Le-Brown/gulugulu/README.md

# gulugulu
Gulugulu drink-maker made by Xu Le and Zhou Mingyuan, which is The special prize work of The 26th Hardware Design Competition at Tsinghua University.

**Finished product schematic:**

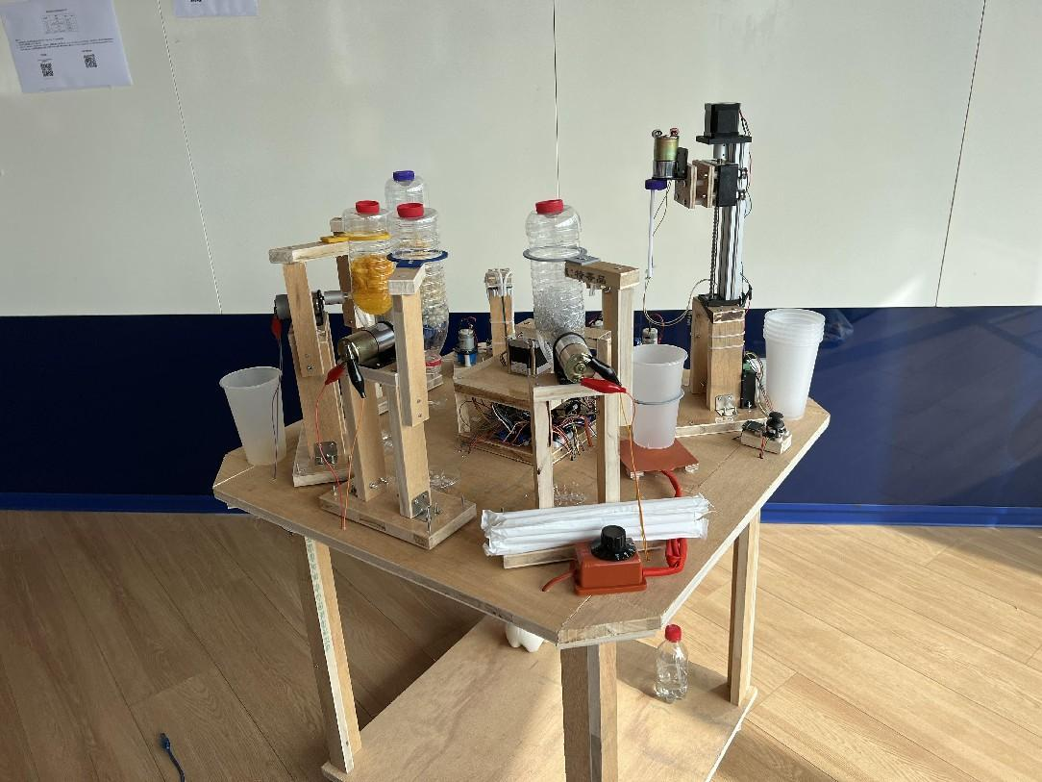
[picture p1: img/成品.png]
成品


Please refer to the project report for project details.
