Le-Brown/gulugulu/Code/README.md

gulugulu-drink-maker文件夹下为下载至饮料机主控单片机Arduino Mega 2560的源代码文件。用于控制饮料机获取订单信息，依照订单信息制作饮品。

wifi_module文件夹下为下载至WifI模块ESP8266的源代码文件。用于搭建网页服务器，与用户交互，获取点单数据，发送至饮料机主控芯片。

Web code文件夹存放了当时设计在线点单网页时的源码，具体使用在了wifi_module.ino文件中。本身并不作为工程的直接源码。
