Le-Brown/gulugulu/3D_print/STL/1.7mm_part2.stl

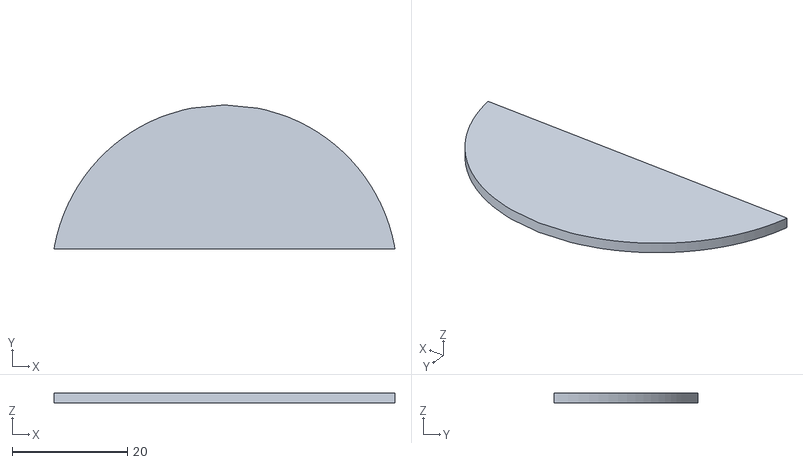
[picture p9: CAD file, 2024-03-18]
3D_print/STL/1.7mm_part2.stl
59.1 x 25.0 x 1.70
