Le-Brown/gulugulu/3D_print/STL/叶片part1.stl

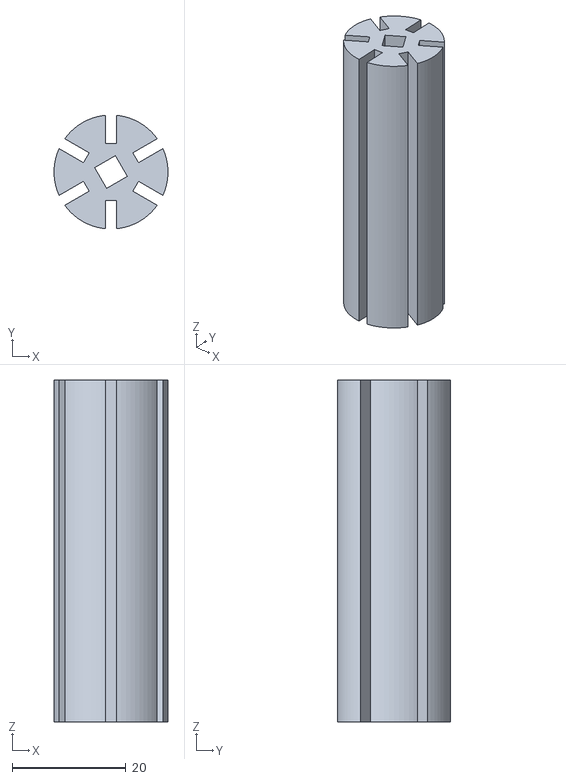
[picture p10: CAD file, 2024-03-18]
3D_print/STL/叶片part1.stl
20.0 x 19.9 x 60.0
