Le-Brown/gulugulu/3D_print/STL/Holder_ver2.stl

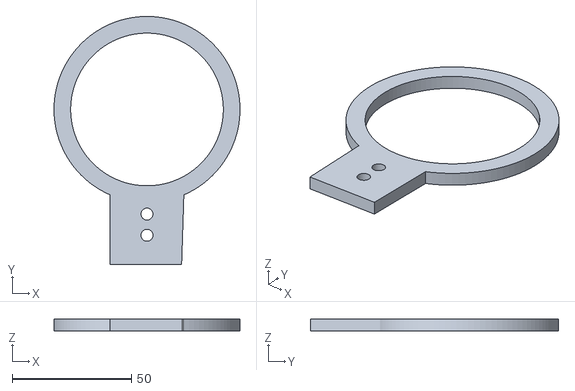
[picture p11: CAD file, 2024-03-18]
3D_print/STL/Holder_ver2.stl
78.0 x 104.0 x 5.00
