Le-Brown/gulugulu/3D_print/STL/arm_holder.stl

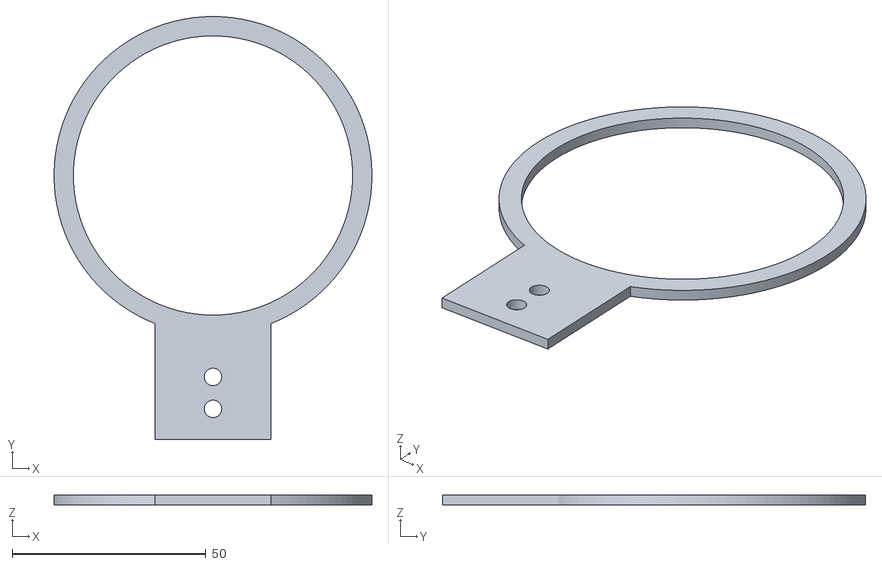
[picture p12: CAD file, 2024-03-18]
3D_print/STL/arm_holder.stl
82.0 x 109.1 x 2.50
