Le-Brown/gulugulu/3D_print/STL/0.9mmpart2stl.stl

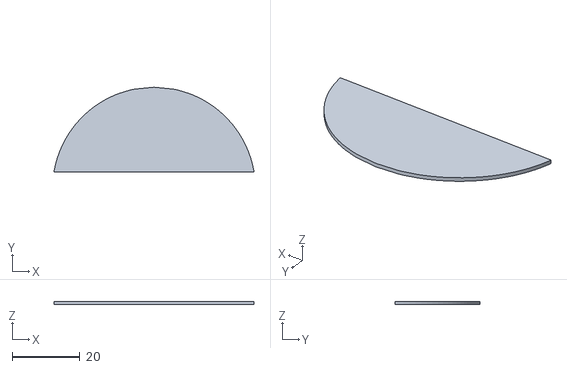
[picture p13: CAD file, 2024-03-18]
3D_print/STL/0.9mmpart2stl.stl
59.1 x 25.0 x 0.9
