Le-Brown/gulugulu/3D_print/STL/3.5mm.stl

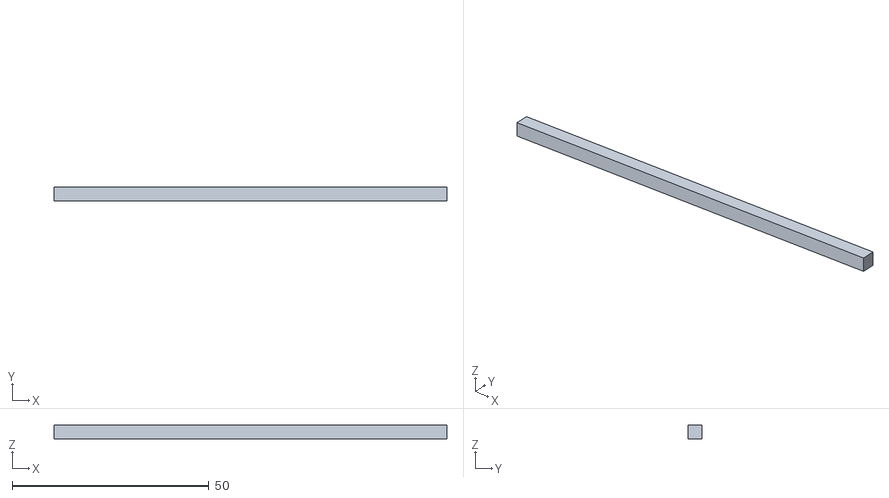
[picture p14: CAD file, 2024-03-18]
3D_print/STL/3.5mm.stl
100.0 x 3.50 x 3.50
