Le-Brown/gulugulu/3D_print/STL/part1.stl

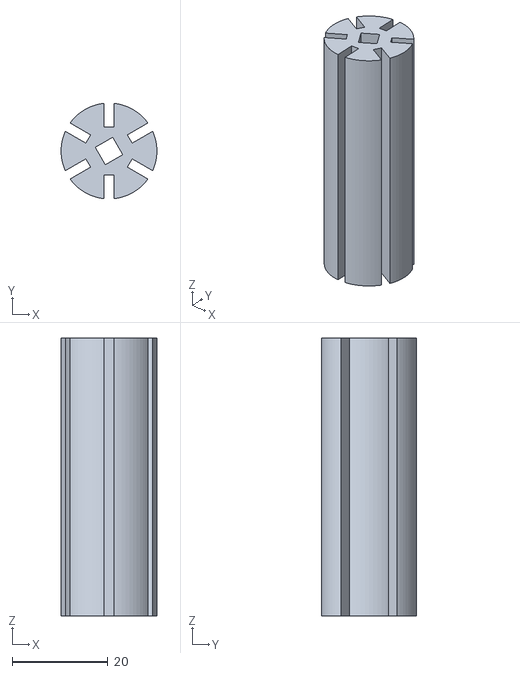
[picture p15: CAD file, 2024-03-18]
3D_print/STL/part1.stl
20.0 x 19.9 x 58.0
