Le-Brown/gulugulu/3D_print/STL/叶片part2.stl

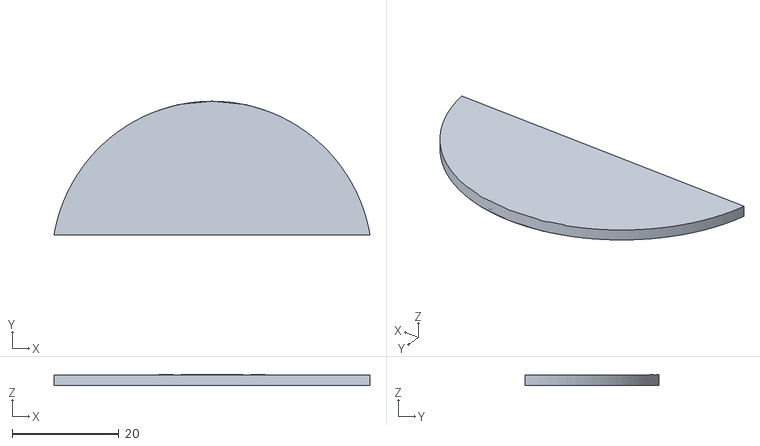
[picture p16: CAD file, 2024-03-18]
3D_print/STL/叶片part2.stl
59.1 x 25.0 x 2.00
