Le-Brown/gulugulu/3D_print/STL/holder2.5mm.stl

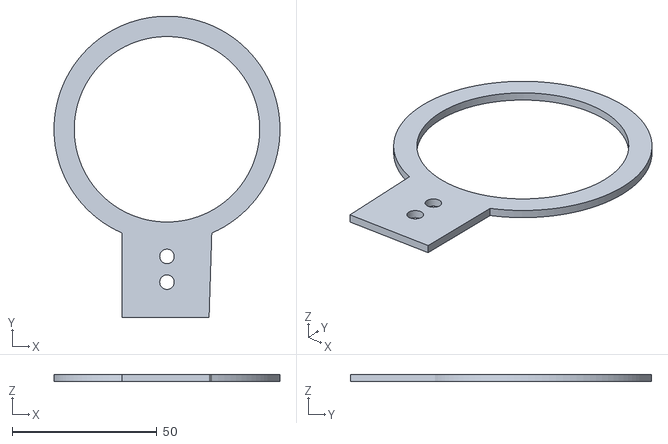
[picture p17: CAD file, 2024-03-18]
3D_print/STL/holder2.5mm.stl
78.0 x 104.0 x 2.50
